ChirpPika/pika-hardware/README.md

# pika-hardware
Hardware design for all Pika models

KiCAD 10
