ChirpPika/pika-hardware/pika_go_0/pika_go_0.kicad_pcb

## KiCad design pika_go_0/pika_go_0.kicad_pcb (2026-09-02)

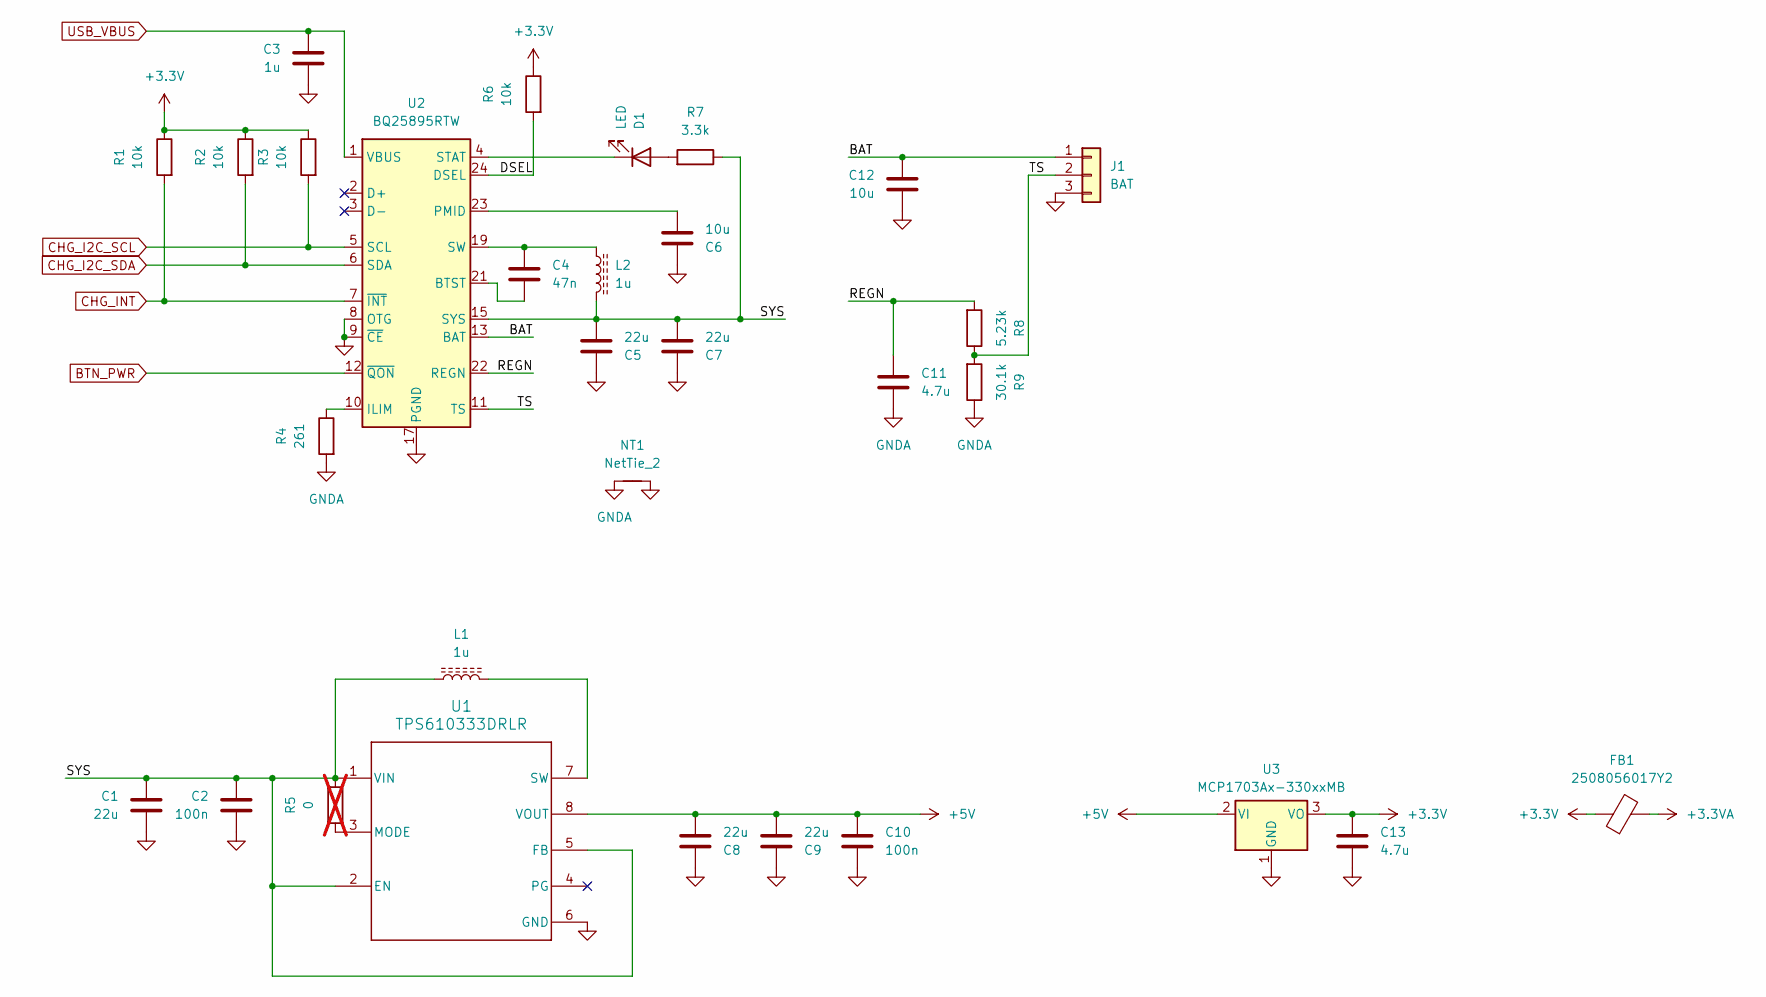
[picture p1: schematic power.kicad_sch]

Parts:
C1, C5, C7, C8, C9: 22u; C_0805_2012Metric_Pad1.18x1.45mm_HandSolder
C2, C10: 100n; C_0603_1608Metric_Pad1.08x0.95mm_HandSolder
C3: 1u; C_0603_1608Metric_Pad1.08x0.95mm_HandSolder
C4: 47n; C_0603_1608Metric_Pad1.08x0.95mm_HandSolder
C6, C12: 10u; C_0603_1608Metric_Pad1.08x0.95mm_HandSolder
C11, C13: 4.7u; C_0603_1608Metric_Pad1.08x0.95mm_HandSolder
D1: LED; LED_0603_1608Metric_Pad1.05x0.95mm_HandSolder
FB1: 2508056017Y2; L_0805_2012Metric_Pad1.05x1.20mm_HandSolder
J1: BAT; JST_PH_S3B-PH-K_1x03_P2.00mm_Horizontal
L1, L2: 1u; L_ABRACON_AMELH4018S
NT1: NetTie_2; NetTie-2_SMD_Pad0.5mm
R1, R2, R3, R6: 10k; R_0603_1608Metric_Pad0.98x0.95mm_HandSolder
R4: 261; R_0603_1608Metric_Pad0.98x0.95mm_HandSolder; Tolerance 1%
R5: 0; R_0603_1608Metric_Pad0.98x0.95mm_HandSolder; not fitted
R7: 3.3k; R_0603_1608Metric_Pad0.98x0.95mm_HandSolder
R8: 5.23k; R_0603_1608Metric_Pad0.98x0.95mm_HandSolder; Tolerance 1%
R9: 30.1k; R_0603_1608Metric_Pad0.98x0.95mm_HandSolder; Tolerance 1%
U1: TPS610333DRLR; SOT-583-8
U2: BQ25895RTW; Texas_RTW_WQFN-24-1EP_4x4mm_P0.5mm_EP2.7x2.7mm_ThermalVias
U3: MCP1703Ax-330xxMB; SOT-89-3

Connections:
+3.3V: C13.1, FB1.1, R1.1, R2.1, R3.1, R6.1, U3.3 (VO); also elsewhere on the board
+3.3VA: FB1.2; also elsewhere on the board
+5V: C8.2, C9.2, C10.1, U1.8 (VOUT), U3.2 (VI); also elsewhere on the board
/Power/BAT: C12.1, J1.1, U2.13 (BAT), U2.14 (BAT)
/Power/DSEL: R6.2, U2.24 (DSEL)
/Power/REGN: C11.1, R8.2, U2.22 (REGN)
/Power/SYS: C1.1, C2.1, C5.2, C7.2, L1.1, L2.2, R5.1, R7.1, U1.1 (VIN), U1.2 (EN), U1.5 (FB), U2.15 (SYS), U2.16 (SYS)
/Power/TS: J1.2, R8.1, R9.2, U2.11 (TS)
BTN_PWR: U2.12 (~QON); also elsewhere on the board
CHG_I2C_SCL: R3.2, U2.5 (SCL); also elsewhere on the board
CHG_I2C_SDA: R2.2, U2.6 (SDA); also elsewhere on the board
CHG_INT: R1.2, U2.7 (~INT); also elsewhere on the board
GND: C1.2, C2.2, C3.2, C5.1, C6.1, C7.1, C8.1, C9.1, C10.2, C12.2, C13.2, J1.3, NT1.2, U1.6 (GND), U2.8 (OTG), U2.9 (~CE), U2.17 (PGND), U2.18 (PGND), U2.25 (PGND), U3.1 (GND); also elsewhere on the board
GNDA: C11.2, NT1.1, R4.2, R9.1
unnamed: C4.1, L2.1, U2.19 (SW), U2.20 (SW)
unnamed: D1.2 (A), R7.2
unnamed: D1.1 (K), U2.4 (STAT)
unnamed: R5.2, U1.3 (MODE)
unnamed: L1.2, U1.7 (SW)
unnamed: C4.2, U2.21 (BTST)
unnamed: R4.1, U2.10 (ILIM)
unnamed: C6.2, U2.23 (PMID)
USB_VBUS: C3.1, U2.1 (VBUS); also elsewhere on the board

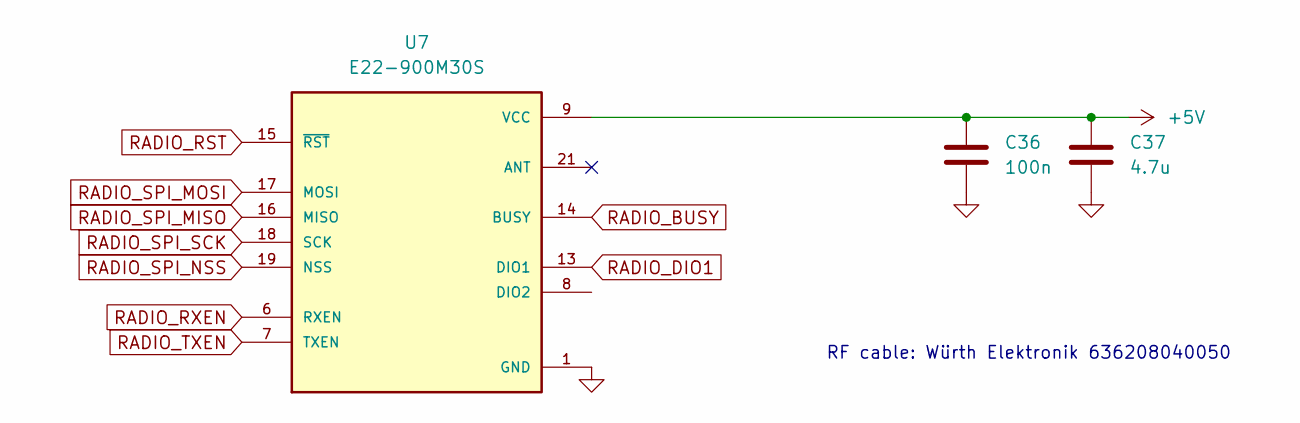
[picture p2: schematic radio.kicad_sch]

Parts:
C36: 100n; C_0603_1608Metric_Pad1.08x0.95mm_HandSolder
C37: 4.7u; C_0603_1608Metric_Pad1.08x0.95mm_HandSolder
U7: E22-900M30S; XCVR_E22-900M30S; PARTREV 1.2

Connections:
+5V: C36.1, C37.1, U7.9 (VCC), U7.10 (VCC); also elsewhere on the board
GND: C36.2, C37.2, U7.1 (GND), U7.2 (GND), U7.3 (GND), U7.4 (GND), U7.5 (GND), U7.11 (GND), U7.12 (GND), U7.20 (GND), U7.22 (GND); also elsewhere on the board
RADIO_BUSY: U7.14 (BUSY); also elsewhere on the board
RADIO_DIO1: U7.13 (DIO1); also elsewhere on the board
RADIO_RST: U7.15 (~RST); also elsewhere on the board
RADIO_RXEN: U7.6 (RXEN); also elsewhere on the board
RADIO_SPI_MISO: U7.16 (MISO); also elsewhere on the board
RADIO_SPI_MOSI: U7.17 (MOSI); also elsewhere on the board
RADIO_SPI_NSS: U7.19 (NSS); also elsewhere on the board
RADIO_SPI_SCK: U7.18 (SCK); also elsewhere on the board
RADIO_TXEN: U7.7 (TXEN); also elsewhere on the board

Notes on the sheet:
RF cable: Würth Elektronik 636208040050

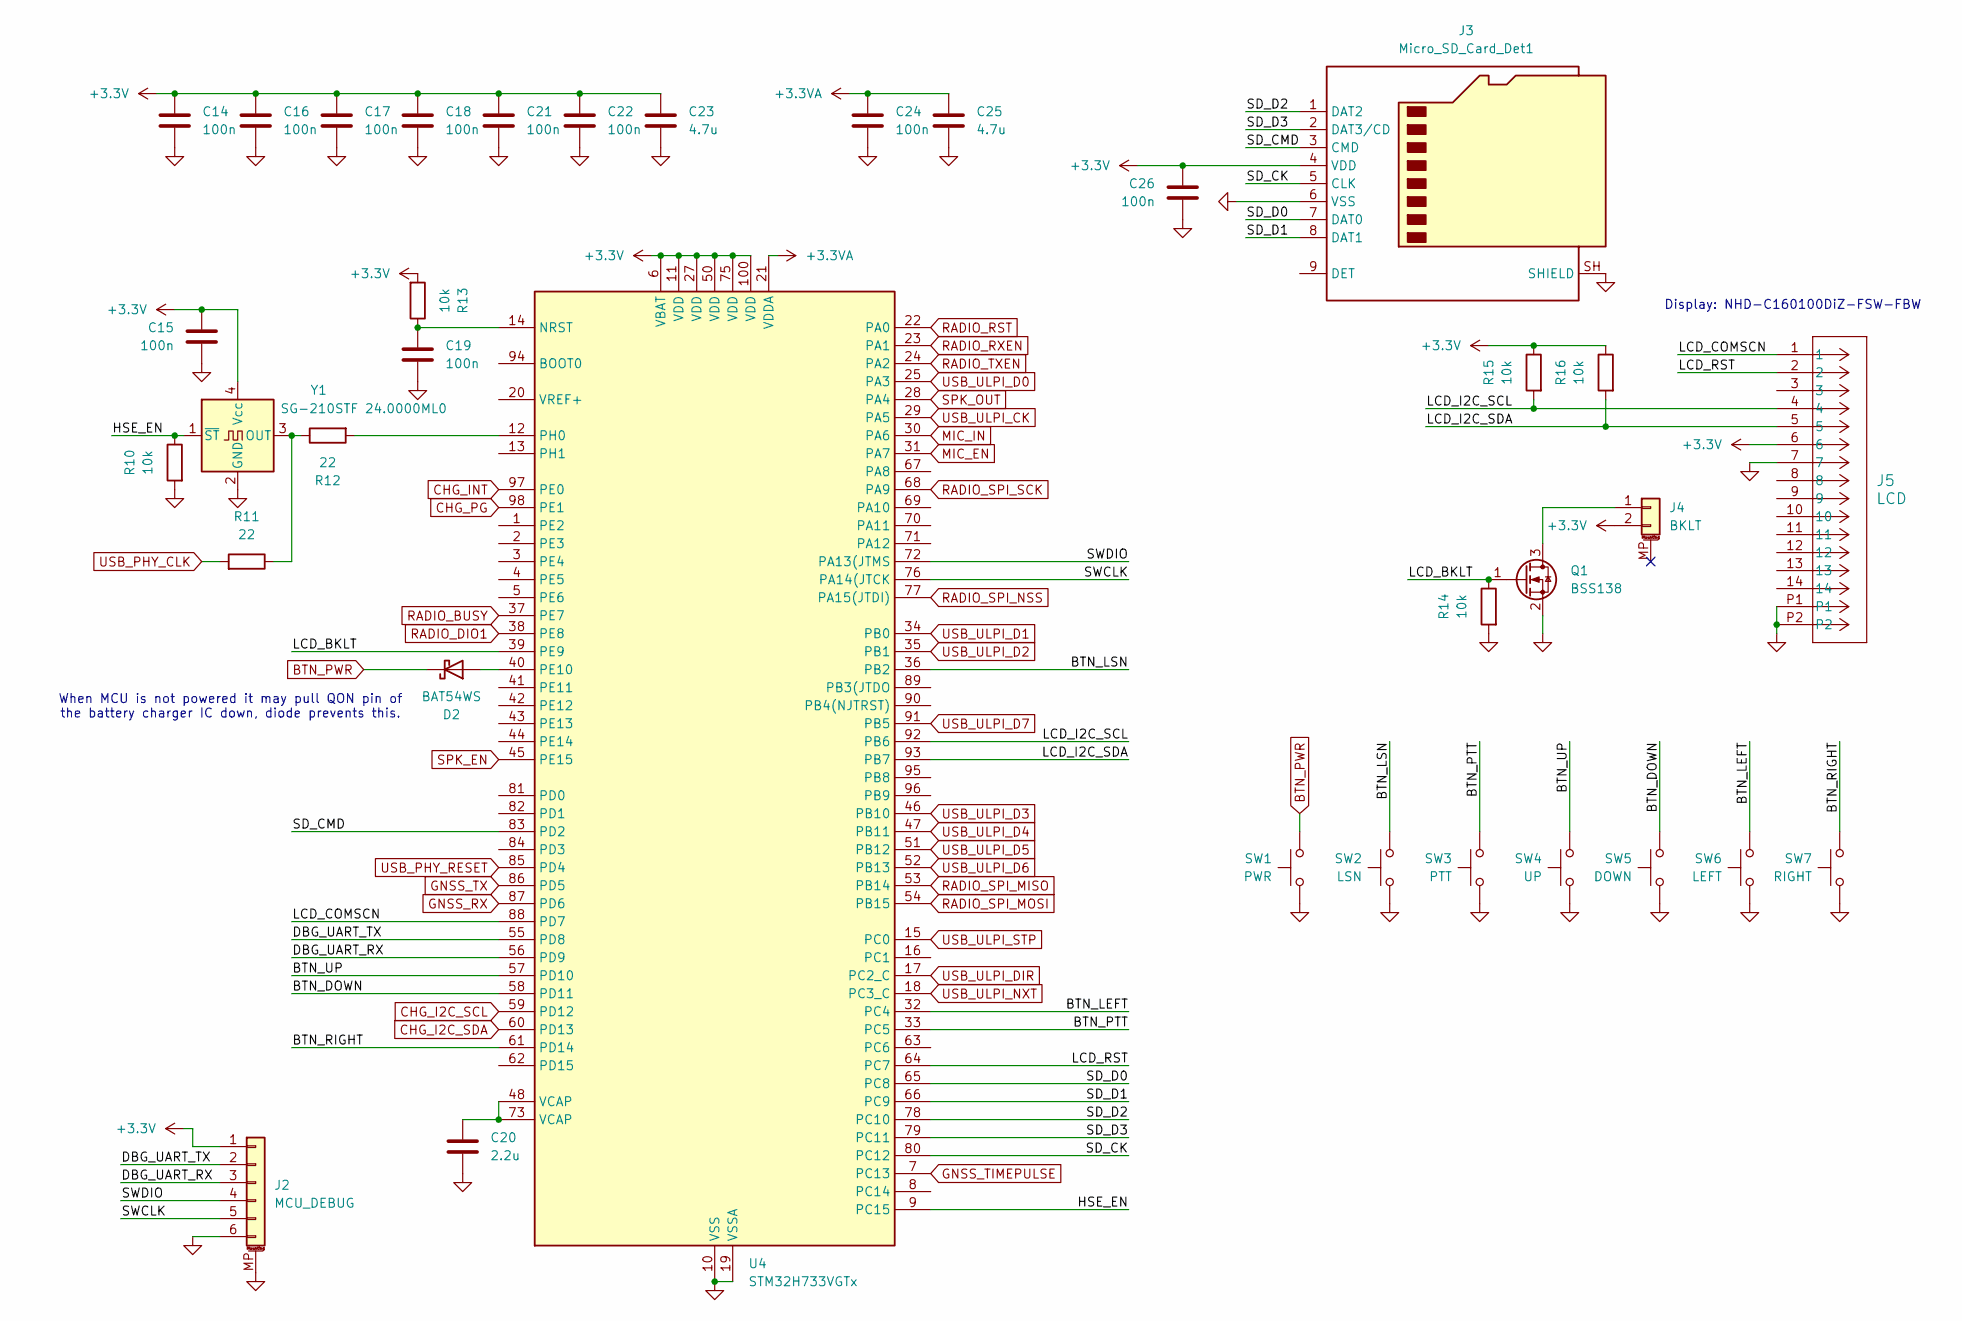
[picture p3: schematic mcu.kicad_sch]

Parts:
C14, C15, C16, C17, C18, C19, C21, C22, C24, C26: 100n; C_0603_1608Metric_Pad1.08x0.95mm_HandSolder
C20: 2.2u; C_0603_1608Metric_Pad1.08x0.95mm_HandSolder
C23, C25: 4.7u; C_0603_1608Metric_Pad1.08x0.95mm_HandSolder
D2: BAT54WS; D_SOD-323_HandSoldering
J2: MCU_DEBUG; JST_SH_SM06B-SRSS-TB_1x06-1MP_P1.00mm_Horizontal
J3: Micro_SD_Card_Det1; CUI_MSD-1-A
J4: BKLT; JST_SH_SM02B-SRSS-TB_1x02-1MP_P1.00mm_Horizontal
J5: LCD; 527461471_MOL
Q1: BSS138; SOT-23
R10, R13, R14, R15, R16: 10k; R_0603_1608Metric_Pad0.98x0.95mm_HandSolder
R11, R12: 22; R_0603_1608Metric_Pad0.98x0.95mm_HandSolder
SW1: PWR; SW_SPST_EVQP7C
SW2: LSN; SW_SPST_EVQP7C
SW3: PTT; SW_SPST_EVQP7C
SW4: UP; TE_STSA
SW5: DOWN; TE_STSA
SW6: LEFT; TE_STSA
SW7: RIGHT; TE_STSA
U4: STM32H733VGTx; LQFP-100_14x14mm_P0.5mm
Y1: SG-210STF 24.0000ML0; Oscillator_SMD_SeikoEpson_SG210-4Pin_2.5x2.0mm

Connections:
+3.3V: C14.1, C15.1, C16.1, C17.1, C18.1, C21.1, C22.1, C23.1, C26.1, J2.1, J3.4 (VDD), J4.2, J5.6, R13.2, R15.1, R16.1, U4.6 (VBAT), U4.11 (VDD), U4.27 (VDD), U4.50 (VDD), U4.75 (VDD), U4.100 (VDD), Y1.4 (Vcc); also elsewhere on the board
+3.3VA: C24.1, C25.1, U4.21 (VDDA); also elsewhere on the board
/MCU/BTN_DOWN: SW5.1, U4.58 (PD11)
/MCU/BTN_LEFT: SW6.1, U4.32 (PC4)
/MCU/BTN_LSN: SW2.1, U4.36 (PB2)
/MCU/BTN_PTT: SW3.1, U4.33 (PC5)
/MCU/BTN_RIGHT: SW7.1, U4.61 (PD14)
/MCU/BTN_UP: SW4.1, U4.57 (PD10)
/MCU/DBG_UART_RX: J2.3, U4.56 (PD9)
/MCU/DBG_UART_TX: J2.2, U4.55 (PD8)
/MCU/HSE_EN: R10.1, U4.9 (PC15), Y1.1 (~ST)
/MCU/LCD_BKLT: Q1.1 (G), R14.1, U4.39 (PE9)
/MCU/LCD_COMSCN: J5.1, U4.88 (PD7)
/MCU/LCD_I2C_SCL: J5.4, R15.2, U4.92 (PB6)
/MCU/LCD_I2C_SDA: J5.5, R16.2, U4.93 (PB7)
/MCU/LCD_RST: J5.2, U4.64 (PC7)
/MCU/SD_CK: J3.5 (CLK), U4.80 (PC12)
/MCU/SD_CMD: J3.3 (CMD), U4.83 (PD2)
/MCU/SD_D0: J3.7 (DAT0), U4.65 (PC8)
/MCU/SD_D1: J3.8 (DAT1), U4.66 (PC9)
/MCU/SD_D2: J3.1 (DAT2), U4.78 (PC10)
/MCU/SD_D3: J3.2 (DAT3/CD), U4.79 (PC11)
/MCU/SWCLK: J2.5, U4.76 (PA14(JTCK)
/MCU/SWDIO: J2.4, U4.72 (PA13(JTMS)
BTN_PWR: D2.1 (K), SW1.1; also elsewhere on the board
CHG_I2C_SCL: U4.59 (PD12); also elsewhere on the board
CHG_I2C_SDA: U4.60 (PD13); also elsewhere on the board
CHG_INT: U4.97 (PE0); also elsewhere on the board
CHG_PG: U4.98 (PE1)
GND: C14.2, C15.2, C16.2, C17.2, C18.2, C19.2, C20.2, C21.2, C22.2, C23.2, C24.2, C25.2, C26.2, J2.6, J2.MP (MountPin), J3.6 (VSS), J3.SH (SHIELD), J5.7, J5.P1, J5.P2, Q1.2 (S), R10.2, R14.2, SW1.2, SW2.2, SW3.2, SW4.2, SW5.2, SW6.2, SW7.2, U4.10 (VSS), U4.19 (VSSA), U4.26 (VSS), U4.49 (VSS), U4.74 (VSS), U4.99 (VSS), Y1.2 (GND); also elsewhere on the board
GNSS_RX: U4.87 (PD6); also elsewhere on the board
GNSS_TIMEPULSE: U4.7 (PC13); also elsewhere on the board
GNSS_TX: U4.86 (PD5); also elsewhere on the board
MIC_EN: U4.31 (PA7); also elsewhere on the board
MIC_IN: U4.30 (PA6); also elsewhere on the board
unnamed: C20.1, U4.48 (VCAP), U4.73 (VCAP)
unnamed: D2.2 (A), U4.40 (PE10)
unnamed: J4.1, Q1.3 (D)
unnamed: C19.1, R13.1, U4.14 (NRST)
unnamed: R12.2, U4.12 (PH0)
unnamed: R11.1, R12.1, Y1.3 (OUT)
RADIO_BUSY: U4.37 (PE7); also elsewhere on the board
RADIO_DIO1: U4.38 (PE8); also elsewhere on the board
RADIO_RST: U4.22 (PA0); also elsewhere on the board
RADIO_RXEN: U4.23 (PA1); also elsewhere on the board
RADIO_SPI_MISO: U4.53 (PB14); also elsewhere on the board
RADIO_SPI_MOSI: U4.54 (PB15); also elsewhere on the board
RADIO_SPI_NSS: U4.77 (PA15(JTDI)); also elsewhere on the board
RADIO_SPI_SCK: U4.68 (PA9); also elsewhere on the board
RADIO_TXEN: U4.24 (PA2); also elsewhere on the board
SPK_EN: U4.45 (PE15); also elsewhere on the board
SPK_OUT: U4.28 (PA4); also elsewhere on the board
USB_PHY_CLK: R11.2; also elsewhere on the board
USB_PHY_RESET: U4.85 (PD4); also elsewhere on the board
USB_ULPI_CK: U4.29 (PA5); also elsewhere on the board
USB_ULPI_D0: U4.25 (PA3); also elsewhere on the board
USB_ULPI_D1: U4.34 (PB0); also elsewhere on the board
USB_ULPI_D2: U4.35 (PB1); also elsewhere on the board
USB_ULPI_D3: U4.46 (PB10); also elsewhere on the board
USB_ULPI_D4: U4.47 (PB11); also elsewhere on the board
USB_ULPI_D5: U4.51 (PB12); also elsewhere on the board
USB_ULPI_D6: U4.52 (PB13); also elsewhere on the board
USB_ULPI_D7: U4.91 (PB5); also elsewhere on the board
USB_ULPI_DIR: U4.17 (PC2_C); also elsewhere on the board
USB_ULPI_NXT: U4.18 (PC3_C); also elsewhere on the board
USB_ULPI_STP: U4.15 (PC0); also elsewhere on the board

Notes on the sheet:
When MCU is not powered it may pull QON pin of the battery charger IC down, diode prevents this.
Display: NHD-C160100DiZ-FSW-FBW

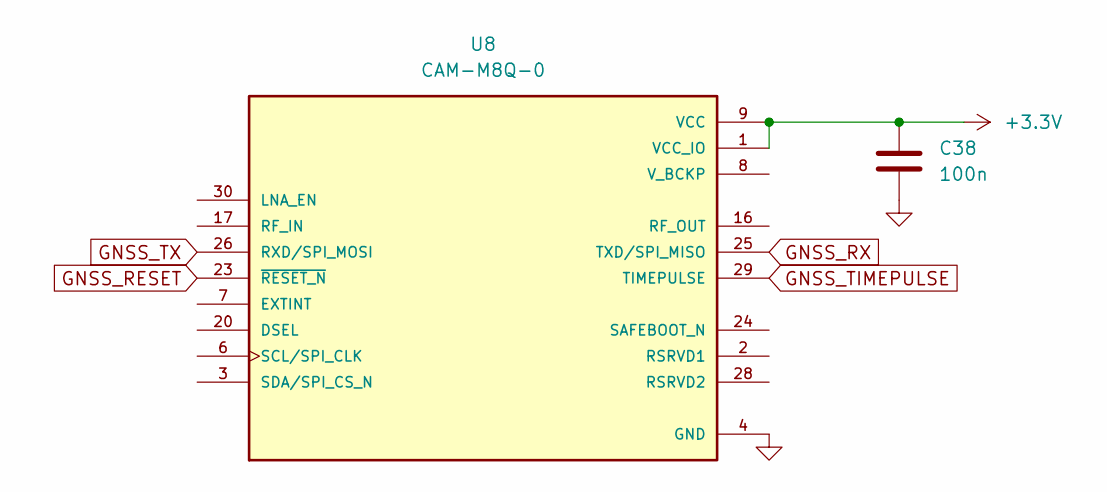
[picture p4: schematic gnss.kicad_sch]

Parts:
C38: 100n; C_0603_1608Metric_Pad1.08x0.95mm_HandSolder
U8: CAM-M8Q-0; LCC100P960X1400X210-31N; DigiKey_Part_Number 672-CAM-M8Q-0CT-ND

Connections:
+3.3V: C38.1, U8.1 (VCC_IO), U8.9 (VCC); also elsewhere on the board
GND: C38.2, U8.4 (GND), U8.5 (GND), U8.10 (GND), U8.11 (GND), U8.12 (GND), U8.13 (GND), U8.14 (GND), U8.15 (GND), U8.18 (GND), U8.19 (GND), U8.21 (GND), U8.22 (GND), U8.27 (GND), U8.31 (GND); also elsewhere on the board
GNSS_RESET: U8.23 (~RESET_N)
GNSS_RX: U8.25 (TXD/SPI_MISO); also elsewhere on the board
GNSS_TIMEPULSE: U8.29 (TIMEPULSE); also elsewhere on the board
GNSS_TX: U8.26 (RXD/SPI_MOSI); also elsewhere on the board

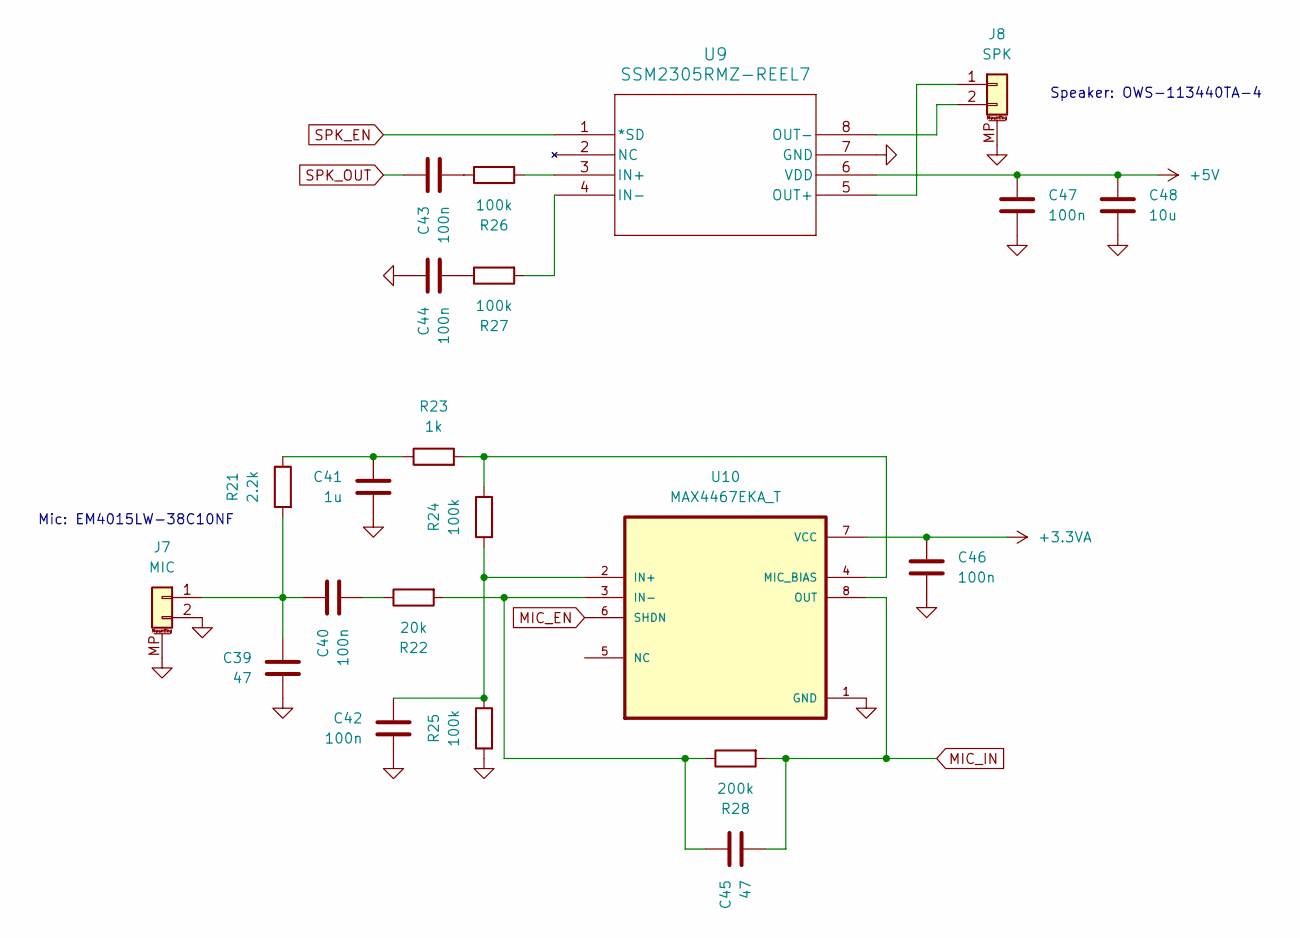
[picture p5: schematic audio.kicad_sch]

Parts:
C39, C45: 47; C_0603_1608Metric_Pad1.08x0.95mm_HandSolder
C40, C42, C43, C44, C46, C47: 100n; C_0603_1608Metric_Pad1.08x0.95mm_HandSolder
C41: 1u; C_0603_1608Metric_Pad1.08x0.95mm_HandSolder
C48: 10u; C_0603_1608Metric_Pad1.08x0.95mm_HandSolder
J7: MIC; Molex_PicoBlade_53261-0271_1x02-1MP_P1.25mm_Horizontal
J8: SPK; Molex_PicoBlade_53261-0271_1x02-1MP_P1.25mm_Horizontal
R21: 2.2k; R_0603_1608Metric_Pad0.98x0.95mm_HandSolder
R22: 20k; R_0603_1608Metric_Pad0.98x0.95mm_HandSolder
R23: 1k; R_0603_1608Metric_Pad0.98x0.95mm_HandSolder
R24, R25, R26, R27: 100k; R_0603_1608Metric_Pad0.98x0.95mm_HandSolder
R28: 200k; R_0603_1608Metric_Pad0.98x0.95mm_HandSolder
U9: SSM2305RMZ-REEL7; MSOP-8_3x3mm_P0.65mm
U10: MAX4467EKA_T; SOT-23-8_Handsoldering; DigiKey_Part_Number MAX4467EKA+CT-ND

Connections:
+3.3VA: C46.1, U10.7 (VCC); also elsewhere on the board
+5V: C47.1, C48.1, U9.6 (VDD); also elsewhere on the board
GND: C39.2, C41.2, C42.2, C44.1, C46.2, C47.2, C48.2, J7.2, J7.MP (MountPin), J8.MP (MountPin), R25.2, U9.7 (GND), U10.1 (GND); also elsewhere on the board
MIC_EN: U10.6 (SHDN); also elsewhere on the board
MIC_IN: C45.2, R28.2, U10.8 (OUT); also elsewhere on the board
unnamed: C40.2, R22.1
unnamed: C41.1, R21.1, R23.1
unnamed: C43.2, R26.1
unnamed: C44.2, R27.1
unnamed: C39.1, C40.1, J7.1, R21.2
unnamed: J8.1, U9.5 (OUT+)
unnamed: J8.2, U9.8 (OUT-)
unnamed: R26.2, U9.3 (IN+)
unnamed: R27.2, U9.4 (IN-)
unnamed: C42.1, R24.2, R25.1, U10.2 (IN+)
unnamed: C45.1, R22.2, R28.1, U10.3 (IN-)
unnamed: R23.2, R24.1, U10.4 (MIC_BIAS)
SPK_EN: U9.1 (*SD); also elsewhere on the board
SPK_OUT: C43.1; also elsewhere on the board

Notes on the sheet:
Mic: EM4015LW-38C10NF
Speaker: OWS-113440TA-4

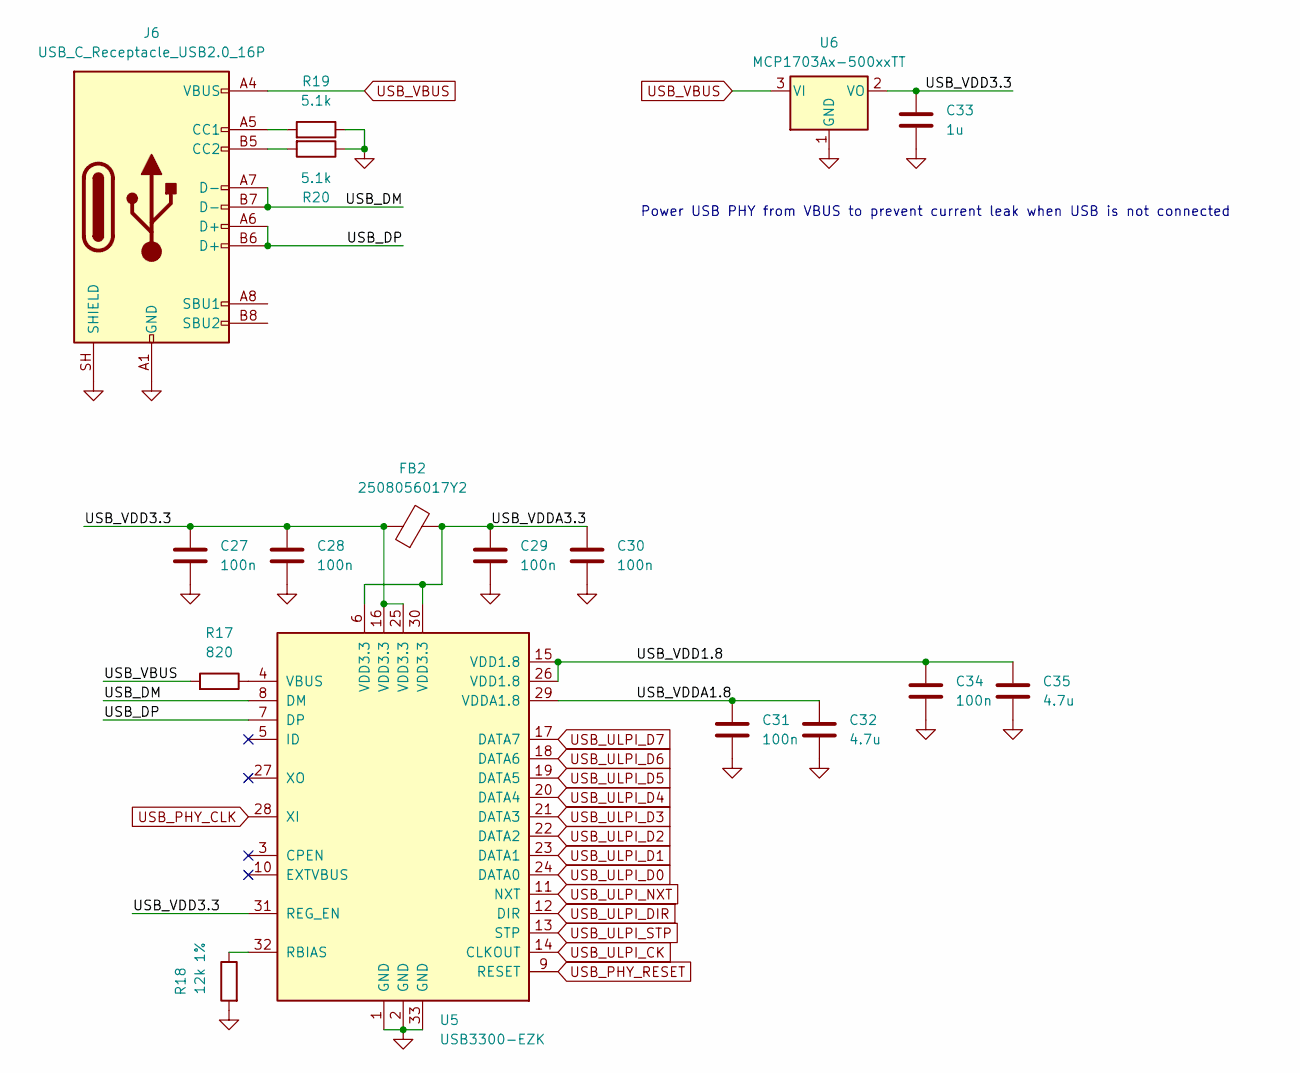
[picture p6: schematic usb.kicad_sch]

Parts:
C27, C28, C29, C30, C31, C34: 100n; C_0603_1608Metric_Pad1.08x0.95mm_HandSolder
C32, C35: 4.7u; C_0603_1608Metric_Pad1.08x0.95mm_HandSolder
C33: 1u; C_0603_1608Metric_Pad1.08x0.95mm_HandSolder
FB2: 2508056017Y2; L_0805_2012Metric_Pad1.05x1.20mm_HandSolder
J6: USB_C_Receptacle_USB2.0_16P; AMPHENOL_12402484E512A
R17: 820; R_0603_1608Metric_Pad0.98x0.95mm_HandSolder; Tolerance 1%
R18: 12k; R_0603_1608Metric_Pad0.98x0.95mm_HandSolder; Tolerance 1%
R19, R20: 5.1k; R_0603_1608Metric_Pad0.98x0.95mm_HandSolder
U5: USB3300-EZK; QFN-32-1EP_5x5mm_P0.5mm_EP3.45x3.45mm
U6: MCP1703Ax-500xxTT; SOT-23

Connections:
/USB/USB_DM: J6.A7 (D-), J6.B7 (D-), U5.8 (DM)
/USB/USB_DP: J6.A6 (D+), J6.B6 (D+), U5.7 (DP)
/USB/USB_VDD1.8: C34.1, C35.1, U5.15 (VDD1.8), U5.26 (VDD1.8)
/USB/USB_VDD3.3: C27.1, C28.1, C33.1, FB2.1, U5.16 (VDD3.3), U5.25 (VDD3.3), U5.31 (REG_EN), U6.2 (VO)
/USB/USB_VDDA1.8: C31.1, C32.1, U5.29 (VDDA1.8)
/USB/USB_VDDA3.3: C29.1, C30.1, FB2.2, U5.6 (VDD3.3), U5.30 (VDD3.3)
GND: C27.2, C28.2, C29.2, C30.2, C31.2, C32.2, C33.2, C34.2, C35.2, J6.A1 (GND), J6.A12 (GND), J6.B1 (GND), J6.B12 (GND), J6.SH (SHIELD), R18.2, R19.1, R20.1, U5.1 (GND), U5.2 (GND), U5.33 (GND), U6.1 (GND); also elsewhere on the board
unnamed: J6.A5 (CC1), R19.2
unnamed: J6.B5 (CC2), R20.2
unnamed: R18.1, U5.32 (RBIAS)
unnamed: R17.1, U5.4 (VBUS)
USB_PHY_CLK: U5.28 (XI); also elsewhere on the board
USB_PHY_RESET: U5.9 (RESET); also elsewhere on the board
USB_ULPI_CK: U5.14 (CLKOUT); also elsewhere on the board
USB_ULPI_D0: U5.24 (DATA0); also elsewhere on the board
USB_ULPI_D1: U5.23 (DATA1); also elsewhere on the board
USB_ULPI_D2: U5.22 (DATA2); also elsewhere on the board
USB_ULPI_D3: U5.21 (DATA3); also elsewhere on the board
USB_ULPI_D4: U5.20 (DATA4); also elsewhere on the board
USB_ULPI_D5: U5.19 (DATA5); also elsewhere on the board
USB_ULPI_D6: U5.18 (DATA6); also elsewhere on the board
USB_ULPI_D7: U5.17 (DATA7); also elsewhere on the board
USB_ULPI_DIR: U5.12 (DIR); also elsewhere on the board
USB_ULPI_NXT: U5.11 (NXT); also elsewhere on the board
USB_ULPI_STP: U5.13 (STP); also elsewhere on the board
USB_VBUS: J6.A4 (VBUS), J6.A9 (VBUS), J6.B4 (VBUS), J6.B9 (VBUS), R17.2, U6.3 (VI); also elsewhere on the board

Notes on the sheet:
Power USB PHY from VBUS to prevent current leak when USB is not connected

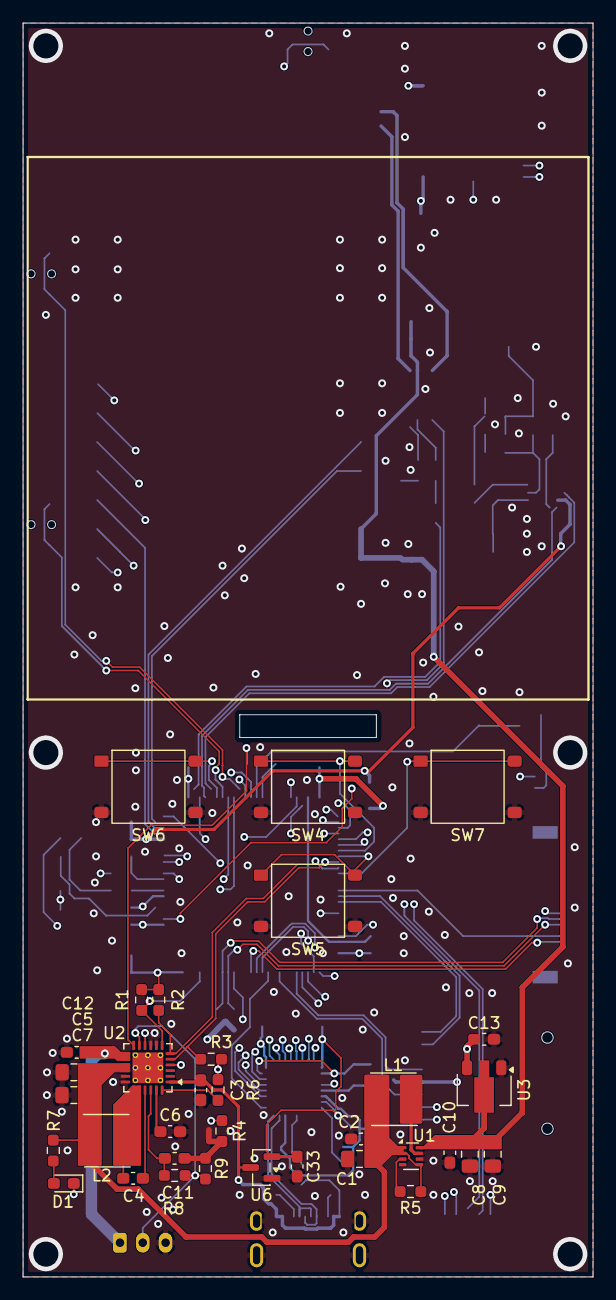
[picture p7: board pika_go_0.kicad_pcb from above]

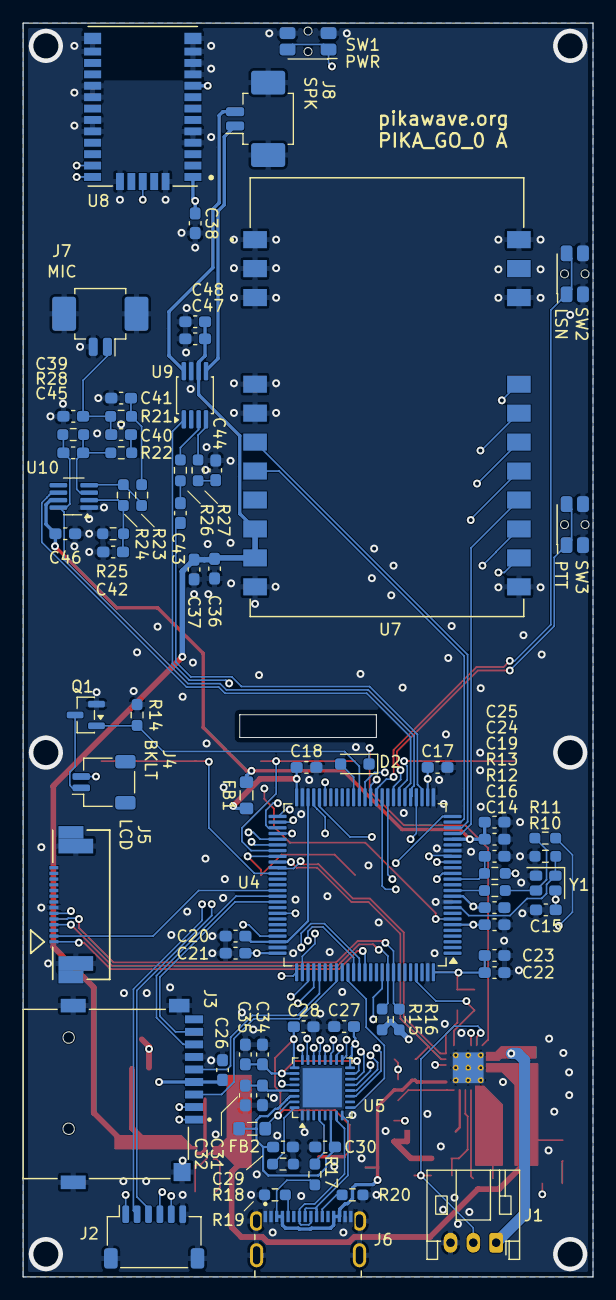
[picture p8: board pika_go_0.kicad_pcb from below]

Board: 4 copper layers, 50.0 x 110.0 mm, 110 parts (75 on the bottom side), 103 nets.
