ChirpPika/pika-hardware/pika_go_0/pika_go_0.ioc

Mcu.UserName=STM32H733VGTx
PA0.Signal=PWR_WKUP1
PA13(JTMS/SWDIO).Signal=DEBUG_JTMS-SWDIO
PA14(JTCK/SWCLK).Signal=DEBUG_JTCK-SWCLK
PA15(JTDI).Signal=SPI1_NSS
PA2.Signal=USART2_TX
PA3.Signal=USART2_RX
PA4.Signal=COMP_DAC11_group
PA5.Signal=SPI1_SCK
PA6.Signal=ADCx_INP3
PA7.Signal=SPI1_MOSI
PB10.Signal=I2C2_SCL
PB11.Signal=I2C2_SDA
PB13.Signal=SDMMC1_D0
PB4(NJTRST).Signal=SPI1_MISO
PB6.Signal=I2C1_SCL
PB7.Signal=I2C1_SDA
PC10.Signal=SDMMC1_D2
PC11.Signal=SDMMC1_D3
PC12.Signal=SDMMC1_CK
PC13.Signal=RTC_TS
PC14-OSC32_IN.Signal=RCC_OSC32_IN
PC15-OSC32_OUT.Signal=RCC_OSC32_OUT
PC9.Signal=SDMMC1_D1
PD2.Signal=SDMMC1_CMD
PD8.Signal=USART3_TX
PD9.Signal=USART3_RX
PH0-OSC_IN.Signal=RCC_OSC_IN
