ChirpPika/pika-hardware/(commit log)

2026-08-19 Initial commit, WIP
    [audio.kicad_sch, gnss.kicad_sch, mcu.kicad_sch, pika_go_0.kicad_pcb, pika_go_0.kicad_sch, radio.kicad_sch, usb_power.kicad_sch]
2026-08-25 Libraries cleanup, schematics finished, copper tracing finished, still need some PCB cleanup
    [audio.kicad_sch, gnss.kicad_sch, mcu.kicad_sch, pika_go_0.kicad_pcb, pika_go_0.kicad_sch, power.kicad_sch, radio.kicad_sch, usb.kicad_sch]
2026-08-26 Footprint library fixes, missing 3D models added
    [pika_go_0.kicad_pcb]
2026-08-28 More 3D models added to library. Use external SMA-U.FL cable instead in SMA connector on PCB edge.
    [pika_go_0.kicad_pcb, radio.kicad_sch]
2026-08-29 Some capacitors footprints changed, minor cleanup
    [audio.kicad_sch, pika_go_0.kicad_pcb, power.kicad_sch]
2026-08-29 Schematic reannotated, cleanup
    [audio.kicad_sch, gnss.kicad_sch, mcu.kicad_sch, pika_go_0.kicad_pcb, power.kicad_sch, radio.kicad_sch, usb.kicad_sch]
2026-08-31 PCB changes, USB-C connector moved to back side
    [pika_go_0.kicad_pcb]
2026-08-31 Side and top buttons moved
    [pika_go_0.kicad_pcb]
2026-08-31 USB PHY routing fix
    [pika_go_0.kicad_pcb]
2026-08-31 Button DN moved
    [pika_go_0.kicad_pcb]
2026-09-01 LCD connectors moved, traces cleanup
    [pika_go_0.kicad_pcb]
2026-09-01 Silk screen cleanup, various fixes after DRC
    [mcu.kicad_sch, pika_go_0.kicad_pcb]
2026-09-02 Diameter of some vias updated
    [pika_go_0.kicad_pcb]
